MarcoWonders/Speedradar/30_Mechanical/lid.stl

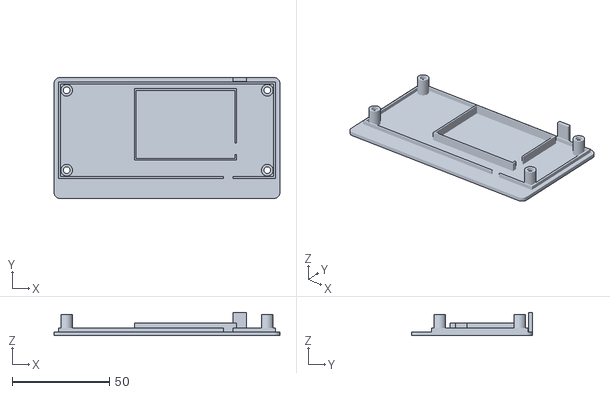
[picture p1: CAD file, 2026-11-14]
30_Mechanical/lid.stl
116.0 x 62.0 x 12.0
