MarcoWonders/Speedradar/30_Mechanical/button_cap.stl

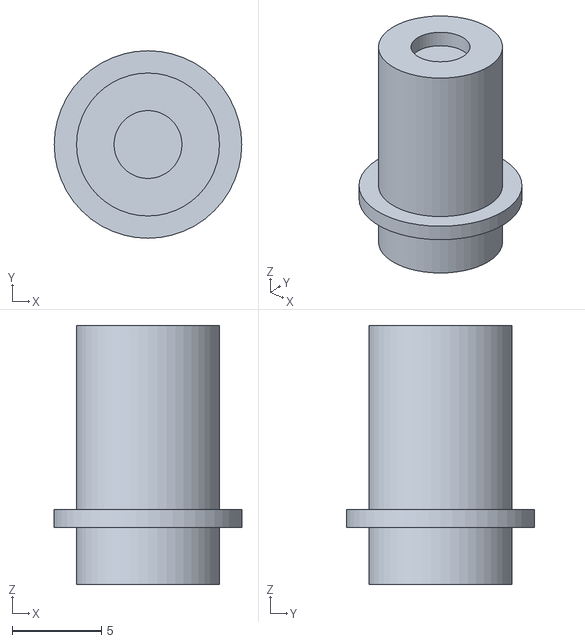
[picture p2: CAD file, 2026-11-14]
30_Mechanical/button_cap.stl
10.5 x 10.5 x 14.5
