MarcoWonders/Speedradar/30_Mechanical/shell.stl

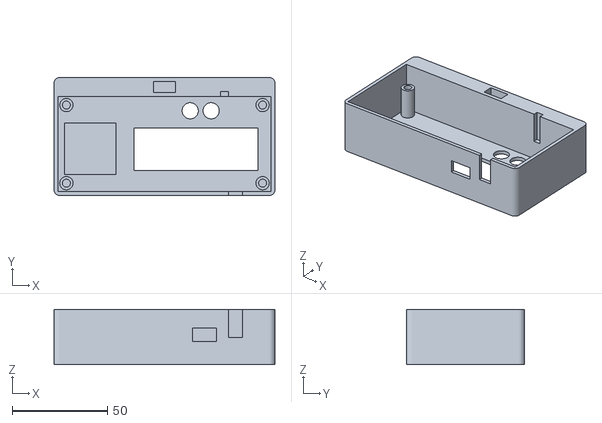
[picture p3: CAD file, 2026-11-14]
30_Mechanical/shell.stl
116.0 x 62.0 x 29.0
