MarcoWonders/Speedradar/20_Hardware/MAR07_SpeedRadar/MAR07_SpeedRadar.kicad_pcb

## KiCad design 20_Hardware/MAR07_SpeedRadar/MAR07_SpeedRadar.kicad_pcb (2026-11-14)

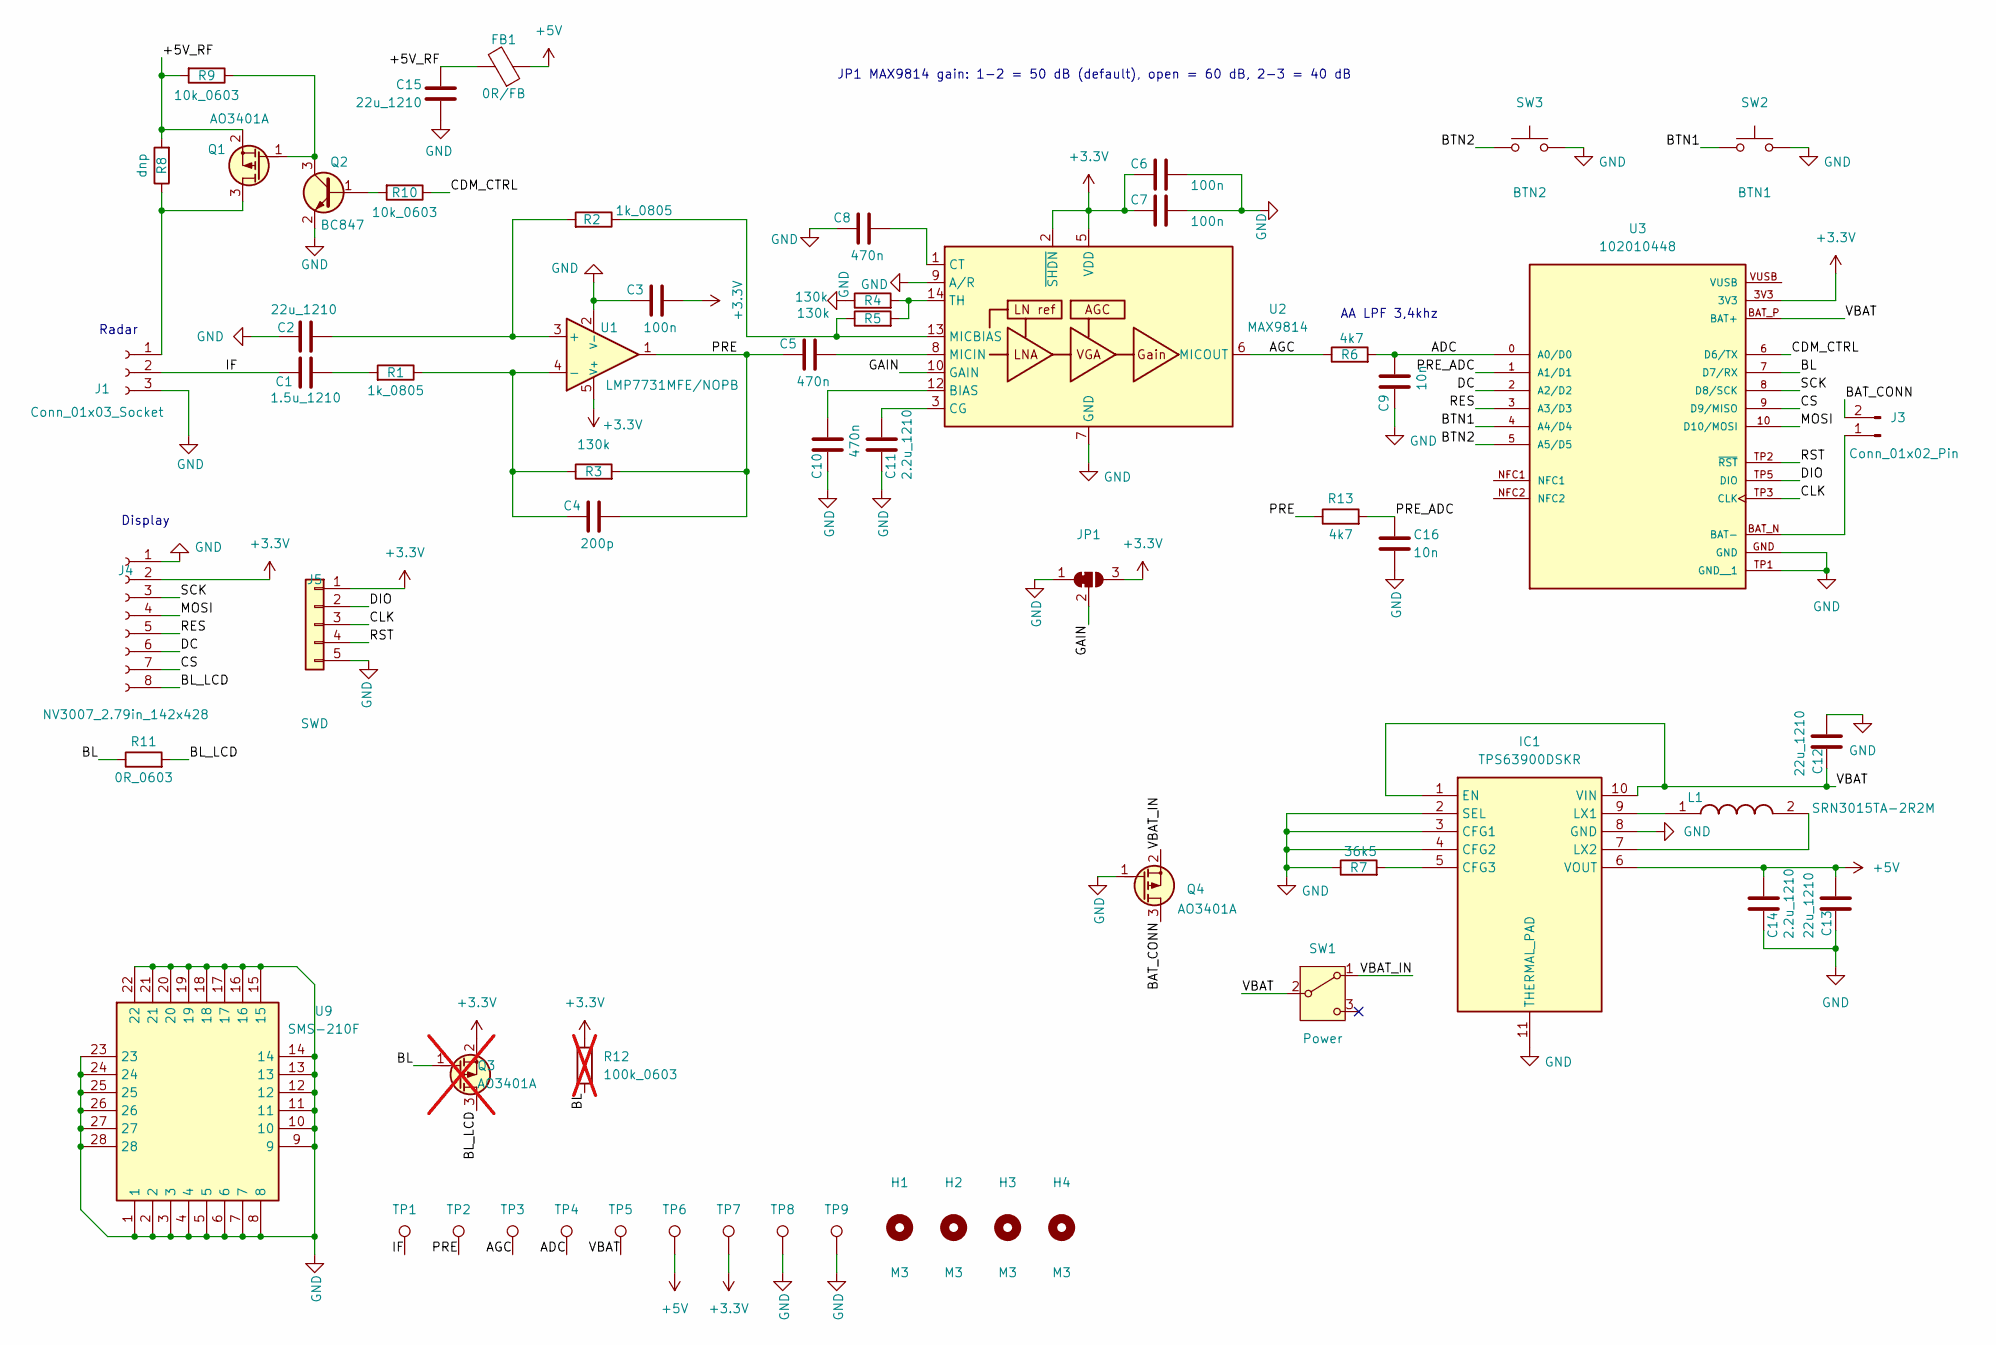
[picture p4: schematic MAR07_SpeedRadar.kicad_sch]

Parts:
C1: 1.5u_1210; C_1210_3225Metric
C2, C12, C13, C15: 22u_1210; C_1210_3225Metric
C3, C6, C7: 100n; C_0603_1608Metric
C4: 200p; C_0603_1608Metric
C5, C8, C10: 470n; C_0603_1608Metric
C9, C16: 10n; C_0603_1608Metric
C11, C14: 2.2u_1210; C_1210_3225Metric
FB1: 0R/FB; L_0805_2012Metric
H1, H2, H3, H4: M3; MountingHole_3.2mm_M3
IC1: TPS63900DSKR; SON50P250X250X80-11N-D; Mouser Part Number 595-TPS63900DSKR
J1: Conn_01x03_Socket; PinSocket_1x03_P2.54mm_Vertical
J3: Conn_01x02_Pin; JST_PH_S2B-PH-K_1x02_P2.00mm_Horizontal
J4: NV3007_2.79in_142x428; PinSocket_1x08_P2.54mm_Vertical
J5: SWD; PinHeader_1x05_P1.27mm_Vertical
JP1: GAIN_SEL; SolderJumper-3_P1.3mm_Bridged12_RoundedPad1.0x1.5mm
L1: SRN3015TA-2R2M; SRN3015TA2R2M; Mouser Part Number 652-SRN3015TA-2R2M
Q1, Q4: AO3401A; SOT-23
Q2: BC847; SOT-23
Q3: AO3401A; SOT-23; not fitted
R1, R2: 1k_0805; R_0805_2012Metric
R3, R4, R5: 130k; R_0603_1608Metric_Pad0.98x0.95mm_HandSolder
R6, R13: 4k7; R_0603_1608Metric_Pad0.98x0.95mm_HandSolder
R7: 36k5; R_0603_1608Metric_Pad0.98x0.95mm_HandSolder
R8: dnp; R_0603_1608Metric_Pad0.98x0.95mm_HandSolder
R9, R10: 10k_0603; R_0603_1608Metric_Pad0.98x0.95mm_HandSolder
R11: 0R_0603; R_0603_1608Metric_Pad0.98x0.95mm_HandSolder
R12: 100k_0603; R_0603_1608Metric_Pad0.98x0.95mm_HandSolder; not fitted
SW1: Power; SW_Slide_SPDT_Angled_CK_OS102011MA1Q
SW2: BTN1; SW_PUSH_6mm
SW3: BTN2; SW_PUSH_6mm
TP1: IF; TestPoint_Pad_D1.5mm
TP2: PRE; TestPoint_Pad_D1.5mm
TP3: AGC; TestPoint_Pad_D1.5mm
TP4: ADC; TestPoint_Pad_D1.5mm
TP5: VBAT; TestPoint_Pad_D1.5mm
TP6: +5V; TestPoint_Pad_D1.5mm
TP7: +3.3V; TestPoint_Pad_D1.5mm
TP8, TP9: GND; TestPoint_Loop_D2.50mm_Drill1.0mm
U1: LMP7731MFE/NOPB; SOT-23-5
U2: MAX9814; DFN-14-1EP_3x3mm_P0.4mm_EP1.78x2.35mm
U3: 102010448; MODULE_102010448; PARTREV 2022/08/18
U9: SMS-210F; SMS210F; Mouser Part Number 861-SMS-210F

Connections:
+3.3V: C3.1, C6.2, C7.2, J4.2, J5.1, JP1.3 (B), Q3.2 (S), R12.1, TP7.1, U1.5 (V+), U2.2 (~SHDN), U2.5 (VDD), U3.3V3
+5V: C13.2, C14.2, FB1.1, IC1.6 (VOUT), TP6.1
/+5V_RF: C15.1, FB1.2, Q1.2 (S), R8.2, R9.2
/ADC: C9.1, R6.2, TP4.1, U3.0 (A0/D0)
/AGC: R6.1, TP3.1, U2.6 (MICOUT)
/BAT_CONN: J3.2, Q4.3 (D)
/BL: Q3.1 (G), R11.1, R12.2, U3.7 (D7/RX)
/BL_LCD: J4.8, Q3.3 (D), R11.2
/BTN1: SW2.1, U3.4 (A4/D4)
/BTN2: SW3.1, U3.5 (A5/D5)
/CDM_CTRL: R10.1, U3.6 (D6/TX)
/CLK: J5.3, U3.TP3 (CLK)
/CS: J4.7, U3.9 (D9/MISO)
/DC: J4.6, U3.2 (A2/D2)
/DIO: J5.2, U3.TP5 (DIO)
/GAIN: JP1.2 (C), U2.10 (GAIN)
/IF: C1.1, J1.2, TP1.1
/MOSI: J4.4, U3.10 (D10/MOSI)
/PRE: C4.1, C5.2, R3.2, R13.1, TP2.1, U1.1
/PRE_ADC: C16.1, R13.2, U3.1 (A1/D1)
/RES: J4.5, U3.3 (A3/D3)
/RST: J5.4, U3.TP2 (~RST)
/SCK: J4.3, U3.8 (D8/SCK)
/VBAT: C12.1, IC1.1 (EN), IC1.10 (VIN), SW1.2 (B), TP5.1, U3.BAT_P (BAT+)
/VBAT_IN: Q4.2 (S), SW1.1 (A)
GND: C2.1, C3.2, C6.1, C7.1, C8.2, C9.2, C10.2, C11.1, C12.2, C13.1, C14.1, C15.2, C16.2, IC1.2 (SEL), IC1.3 (CFG1), IC1.4 (CFG2), IC1.8 (GND), IC1.11 (THERMAL_PAD), J1.3, J4.1, J5.5, JP1.1 (A), Q2.2 (E), Q4.1 (G), R4.1, R7.1, SW2.2, SW3.2, TP8.1, TP9.1, U1.2 (V-), U2.4 (GND), U2.7 (GND), U2.9 (A/R), U2.11 (GND), U2.15 (GND), U3.GND, U3.TP1 (GND__1), U9.1, U9.2, U9.3, U9.4, U9.5, U9.6, U9.7, U9.8, U9.9, U9.10, U9.11, U9.12, U9.13, U9.14, U9.15, U9.16, U9.17, U9.18, U9.19, U9.20, U9.21, U9.22, U9.23, U9.24, U9.25, U9.26, U9.27, U9.28
unnamed: C1.2, R1.1
unnamed: IC1.5 (CFG3), R7.2
unnamed: IC1.9 (LX1), L1.1
unnamed: IC1.7 (LX2), L1.2
unnamed: J1.1, Q1.3 (D), R8.1
unnamed: J3.1, U3.BAT_N (BAT-)
unnamed: Q1.1 (G), Q2.3 (C), R9.1
unnamed: Q2.1 (B), R10.2
unnamed: C2.2, R2.1, U1.3 (+)
unnamed: C4.2, R1.2, R3.1, U1.4 (-)
unnamed: C10.1, U2.12 (BIAS)
unnamed: C11.2, U2.3 (CG)
unnamed: C8.1, U2.1 (CT)
unnamed: R2.2, R5.1, U2.13 (MICBIAS)
unnamed: C5.1, U2.8 (MICIN)
unnamed: R4.2, R5.2, U2.14 (TH)

Notes on the sheet:
Radar
JP1 MAX9814 gain: 1-2 = 50 dB (default), open = 60 dB, 2-3 = 40 dB
Display
AA LPF 3,4khz

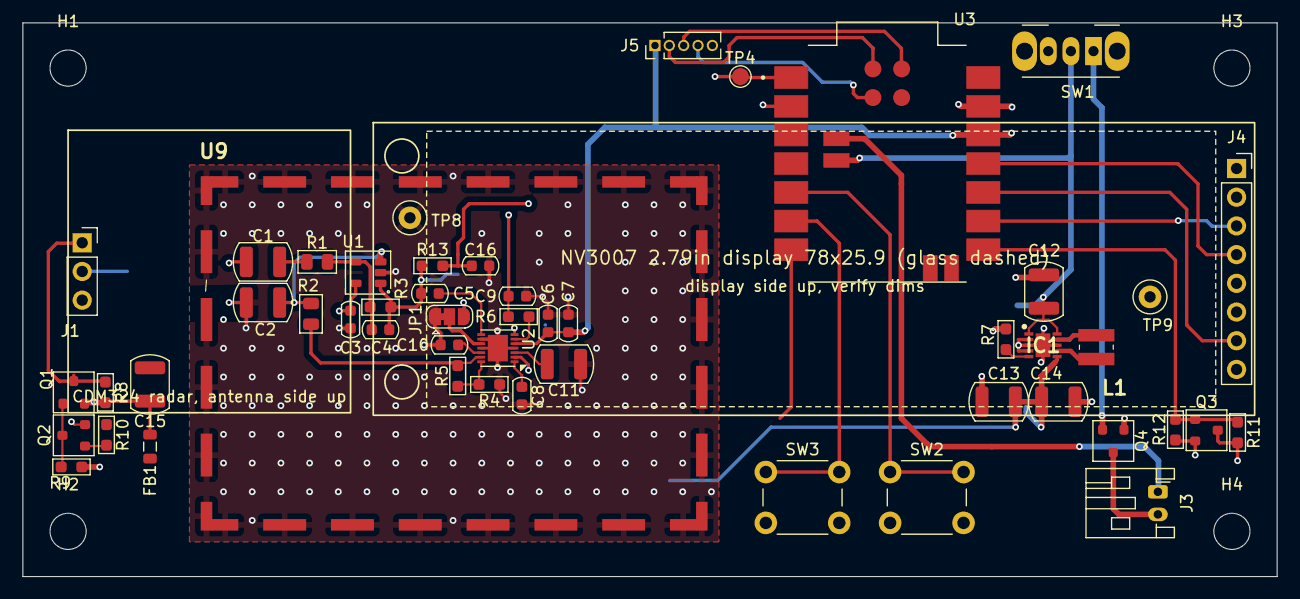
[picture p5: board MAR07_SpeedRadar.kicad_pcb from above]

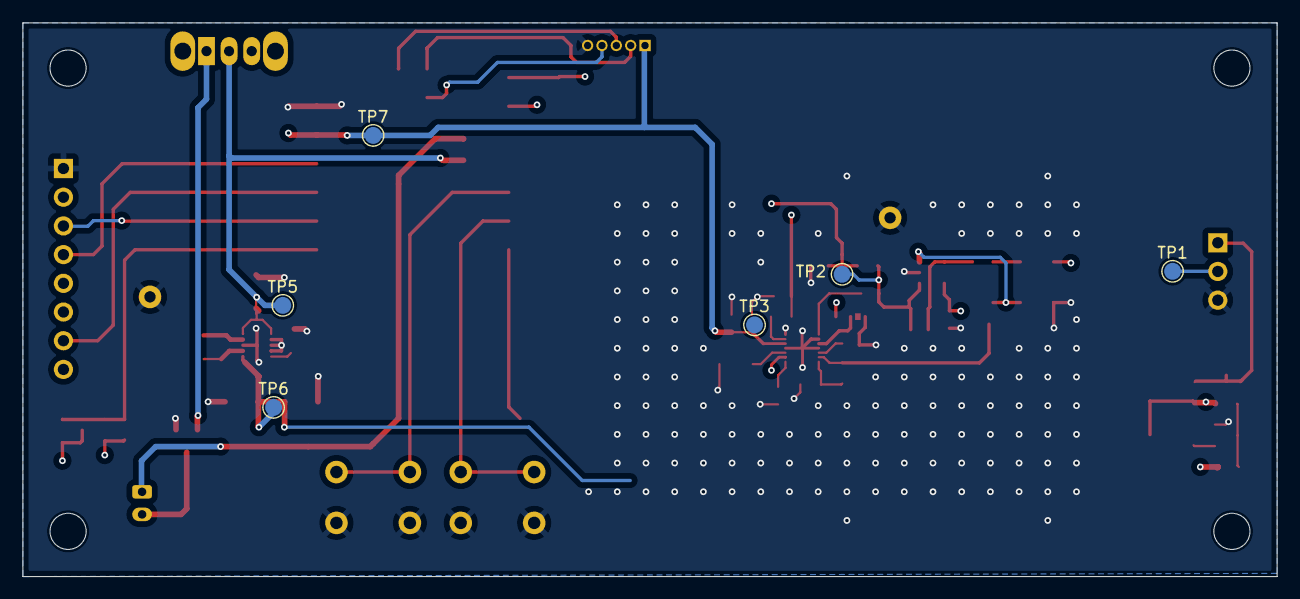
[picture p6: board MAR07_SpeedRadar.kicad_pcb from below]

Board: 4 copper layers, 111.0 x 49.0 mm, 61 parts (6 on the bottom side), 42 nets.
