MarcoWonders/Speedradar/(commit log)

2026-11-08 Initial commit: CDM324 Doppler speed radar for long jump run-ups
    KiCad 9 schematic and PCB for a battery-powered speed radar with an
    NV3007 TFT display, based on limpkin's CDM324 Doppler backpack.
    [MAR07_SpeedRadar.kicad_pcb, MAR07_SpeedRadar.kicad_sch]
2026-11-08 Add prototype bring-up options to schematic
    - Test points on IF, preamp, AGC and ADC signals, supply rails and GND
    - JP1 solder jumper for MAX9814 gain (40/50/60 dB)
    - FB1 + C15 filter on the radar 5 V supply (+5V_RF)
    - Backlight: 0R direct drive, optional high-side P-FET (DNP)
    - Q4 P-FET battery reverse-polarity protection
    - Raw preamp tap to A1 via 3.4 kHz RC; display CS moved to D9
    - SWD header and M3 mounting holes
    - README: updated pin mapping and prototype options table
    [MAR07_SpeedRadar.kicad_sch]
2026-11-08 PCB: initial placement, module outlines, grid-aligned holes and buttons
    - Parts placed on a 111 x 49 mm board, outline on a 1 mm grid (144,75)-(255,124)
    - Silkscreen/courtyard outlines for the NV3007 display (J4) and CDM324 (J1)
    - Mounting holes 4 mm in from each corner: 103 x 41 mm M3 pattern
    - H4 moved onto the board; J3 and Q4 shifted to clear it
    - Button centres on 1 mm grid, 11 mm apart (SW2 213,117 / SW3 224,117)
    - Schematic tidied and grouped
    [MAR07_SpeedRadar.kicad_pcb, MAR07_SpeedRadar.kicad_sch]
2026-11-08 PCB placement update and enclosure concept drawing (routing WIP)
    - XIAO moved to the top edge so the USB-C port is reachable
    - SW1 changed to angled slide switch (OS102011MA1Q) on the top edge
    - Routing is NOT finished yet
    - 30_Mechanical: 2D enclosure concept (front shell + back lid, tripod
    nut plinth, display window, radome, button holes), generated by a
    parametric script in PCB coordinates
    - README: status and repository layout
    [MAR07_SpeedRadar.kicad_pcb, MAR07_SpeedRadar.kicad_sch]
2026-11-10 Layout WIP and battery placement in enclosure drawing
    - PCB: ongoing layout work, buttons swapped (still on the 213/224, y117
    grid), J3 rotated so the battery plug enters from the left.
    Routing is still in progress.
    - Enclosure drawing: USB-C and switch slot at the final XIAO/SW1 positions,
    LiPo 503450 in a tray on the back lid, wire groove in the plinth under
    the PCB edge to the J3 plug.
    [MAR07_SpeedRadar.kicad_pcb]
2026-11-11 PCB: layout mostly routed (WIP)
    4-layer board, In1 = GND plane. Remaining DRC items: 5 unrouted
    connections (DC, RES, R9 +5V_RF, U2 +3.3V stub, AGC via) plus the XIAO
    bottom GND pad, a few real clearance issues at the TPS63900 LX traces and
    MAX9814 GAIN, and the board min width/clearance rules (0.3/0.25) are
    stricter than the 0.2 mm netclass used for the fine-pitch parts.
    [MAR07_SpeedRadar.kicad_pcb, MAR07_SpeedRadar.kicad_sch]
2026-11-14 Enclosure 3D model and STLs (unverified), layout progress
    - 30_Mechanical/enclosure_3d.py builds shell, lid and button cap STLs
    from the drawing parameters and runs a collision check first
    - NOTE: STLs still need checking against the real parts; the fit check
    uses estimated module heights and display glass position (see README)
    - Design fixes from the fit check: SW1 slot open to the back with a lid
    tongue, slot moved to the lever position, Ø7 insert bosses, M3x16,
    tripod nut slides into a slot from the back
    - PCB: routing progress, board min clearance set to 0.13 mm
    [MAR07_SpeedRadar.kicad_pcb, button_cap.stl, lid.stl, shell.stl]
